1tts/buck-converter-design/Board Sim Pictures/Vdroop 3A-2A.jpg

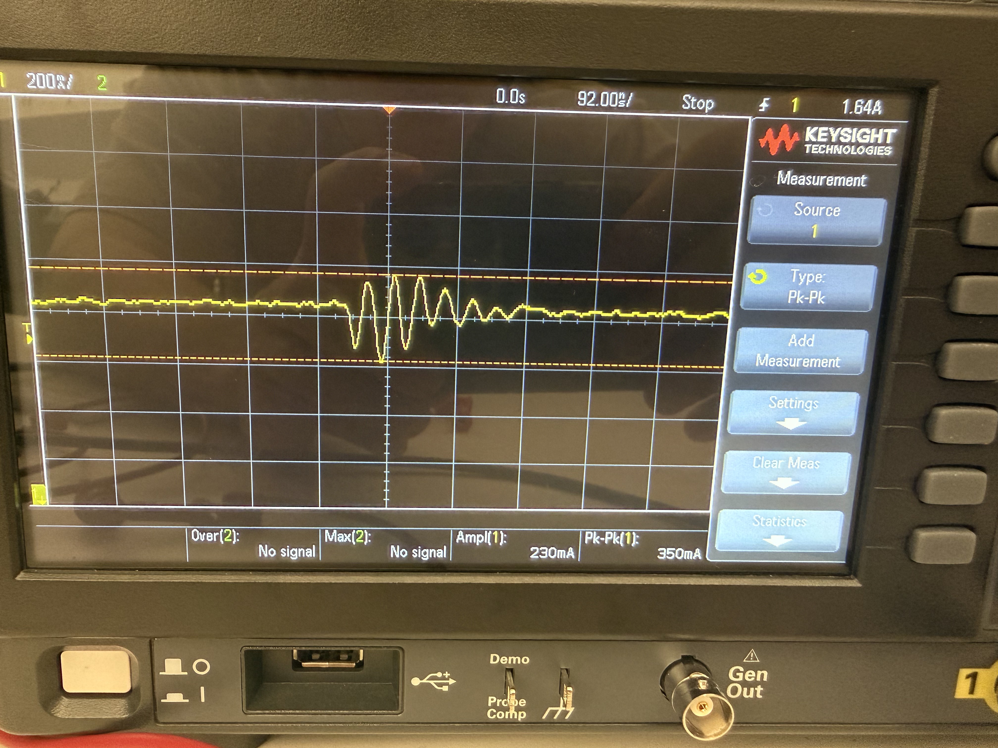
Board Sim Pictures/Vdroop 3A-2A.jpg
