1tts/buck-converter-design/Board Sim Pictures/Output Ripple @ full load.jpg

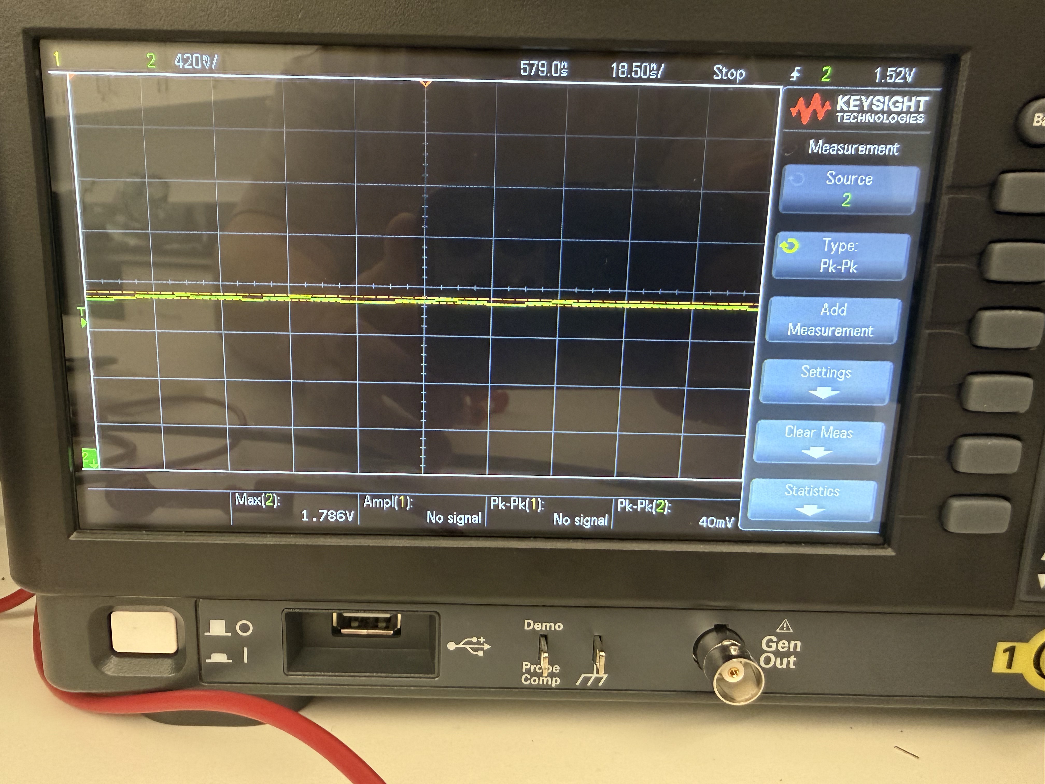
Board Sim Pictures/Output Ripple @ full load.jpg
