1tts/buck-converter-design/README.md

# Design & Schematics for 5V - 1.8V DC Synchronous Buck Converter
