1tts/buck-converter-design/Board Sim Pictures/board.jpg

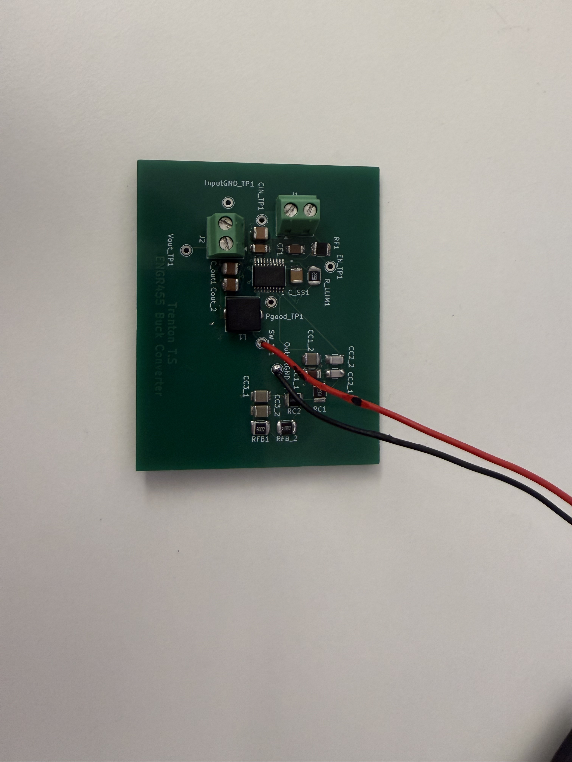
Board Sim Pictures/board.jpg
