1tts/buck-converter-design/Board Sim Pictures/DC Out.jpg

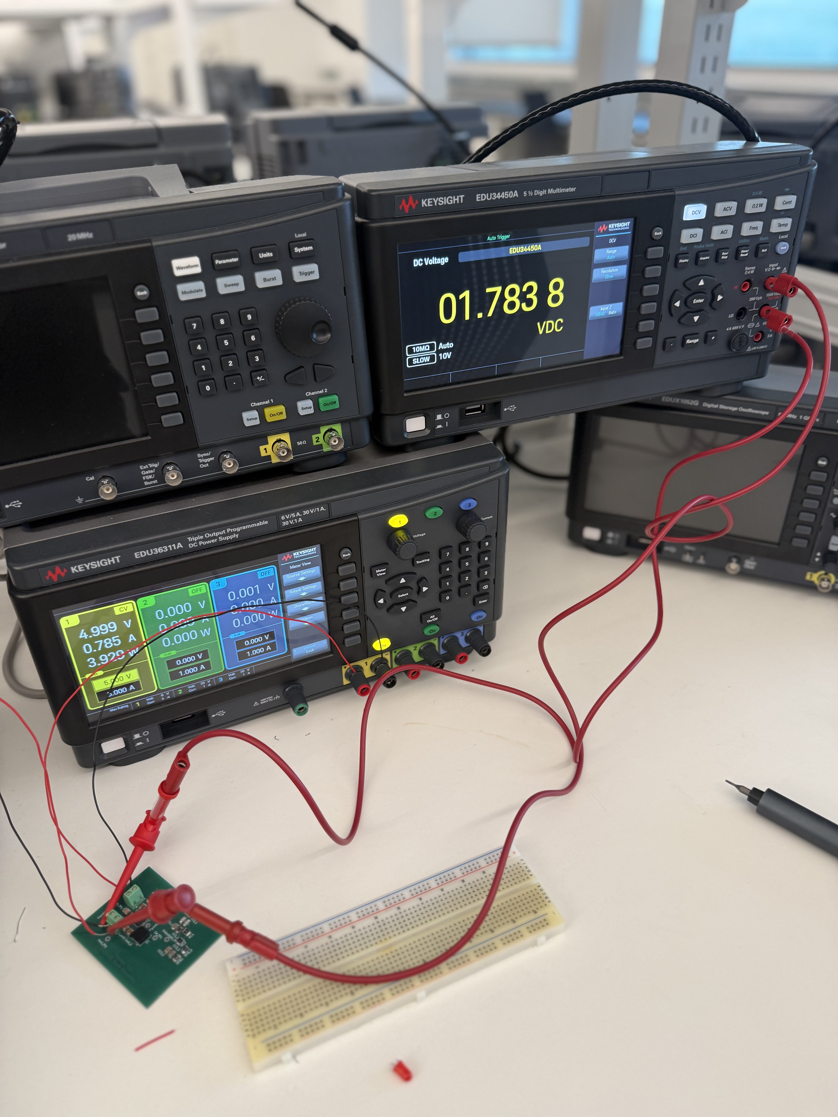
Board Sim Pictures/DC Out.jpg
