1tts/buck-converter-design/Board Sim Pictures/full-load confirmation.png

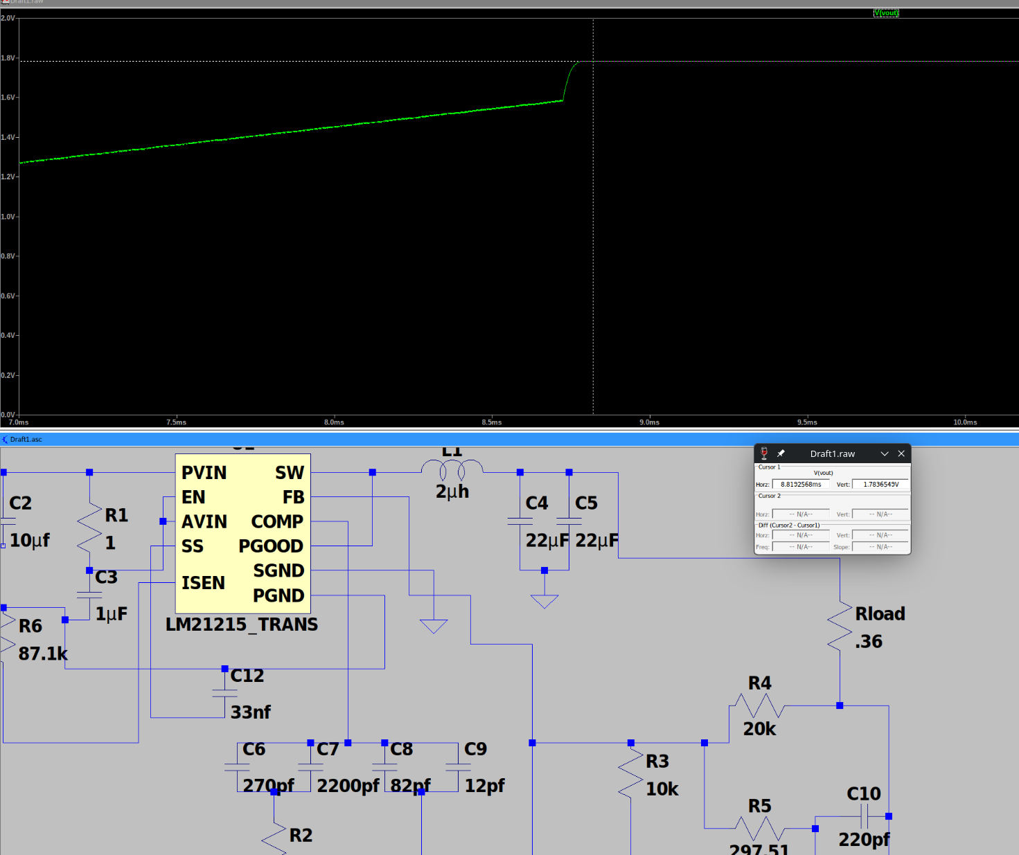
Board Sim Pictures/full-load confirmation.png
