1tts/buck-converter-design/Board Sim Pictures/IMG_9958.jpg

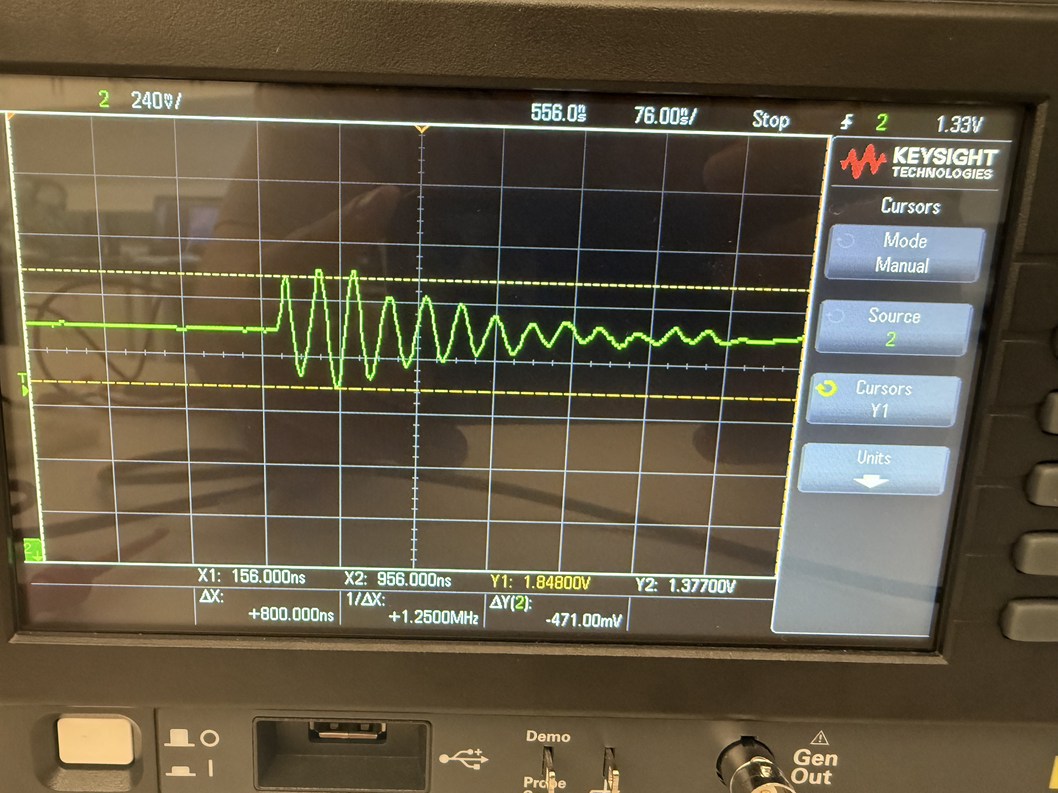
Board Sim Pictures/IMG_9958.jpg
