1tts/buck-converter-design/Board Sim Pictures/inductor_ripple.png

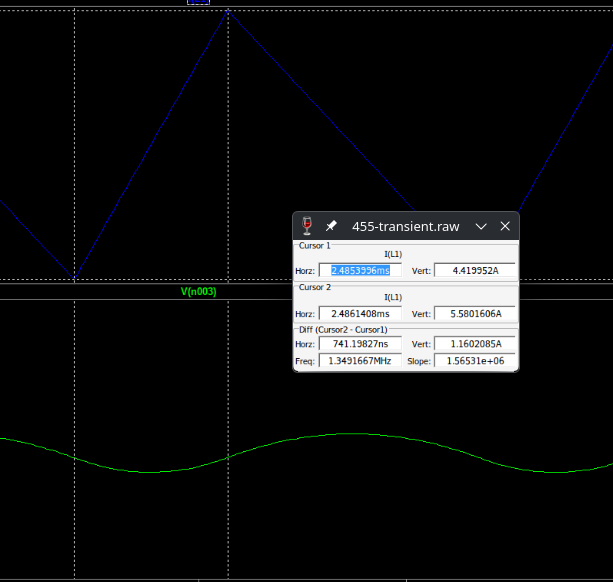
Board Sim Pictures/inductor_ripple.png
