1tts/buck-converter-design/Board Sim Pictures/load_spike_vdroop_pass.png

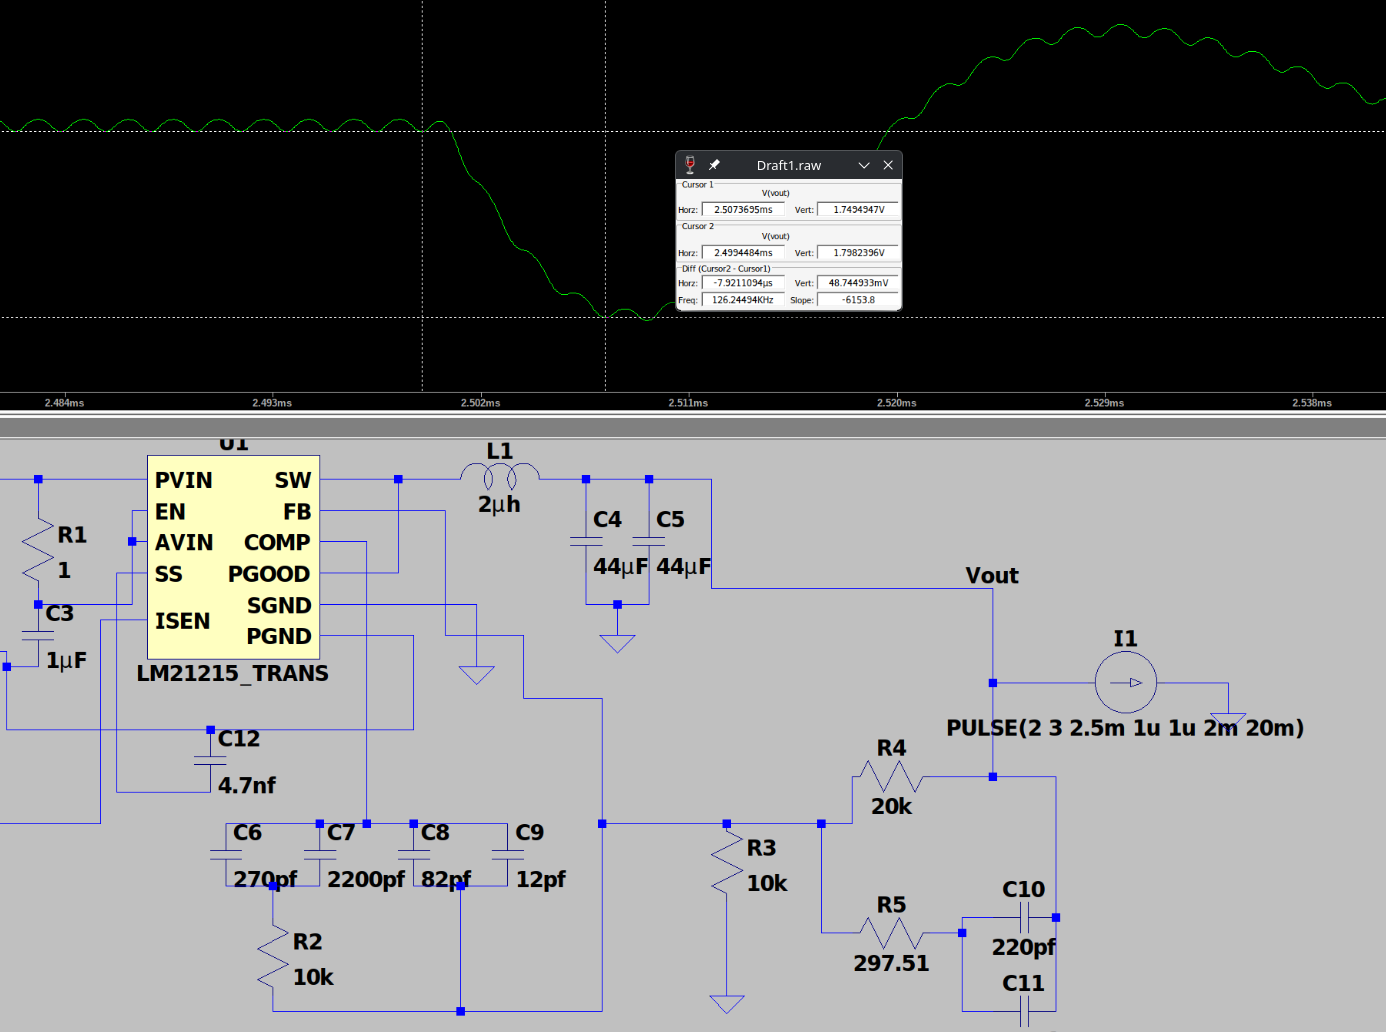
Board Sim Pictures/load_spike_vdroop_pass.png
