1tts/buck-converter-design/Board Sim Pictures/transient-2-rings.png

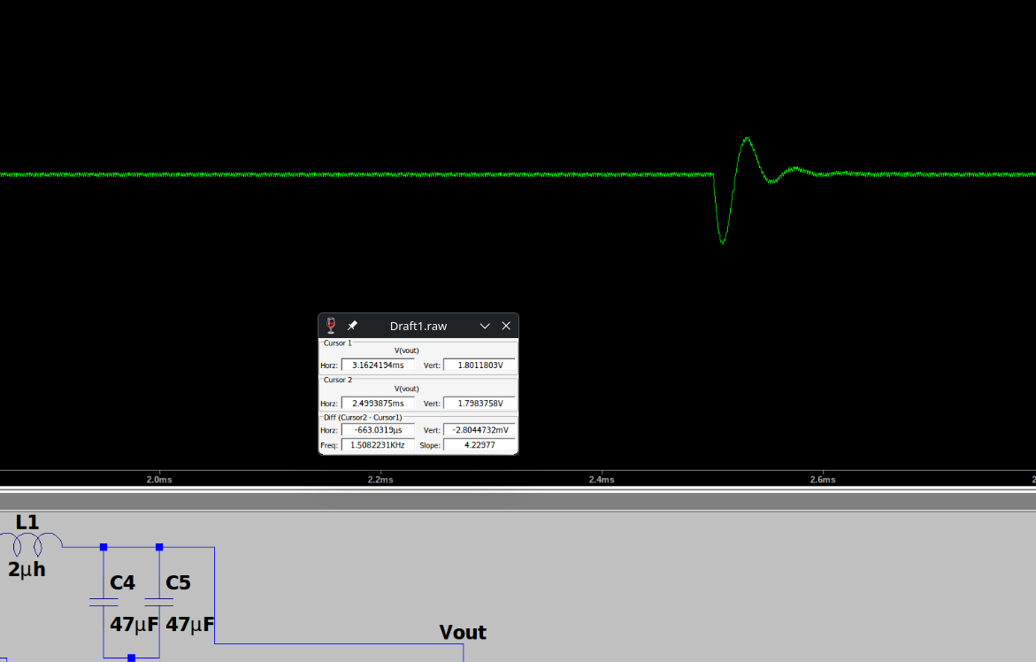
Board Sim Pictures/transient-2-rings.png
