1tts/buck-converter-design/Board Sim Pictures/transient-confirmation.png

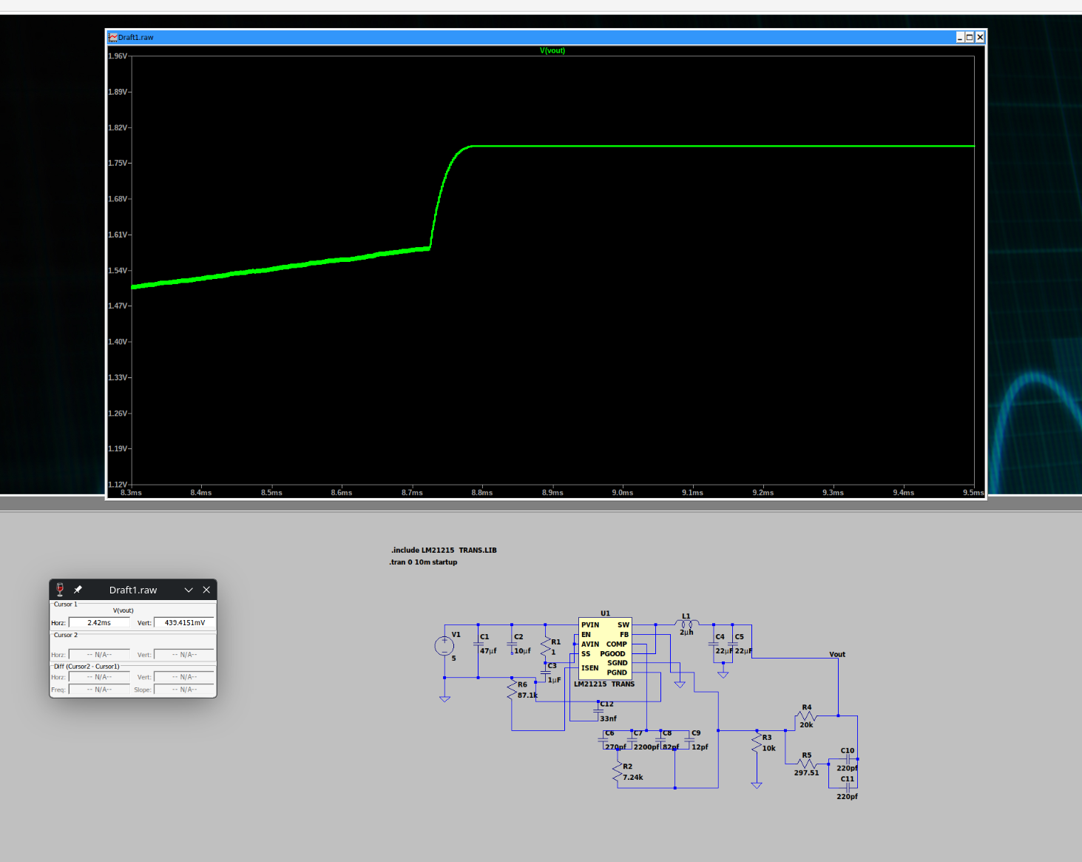
Board Sim Pictures/transient-confirmation.png
