1tts/buck-converter-design/Board Sim Pictures/Vdroop 2A-3A.jpg

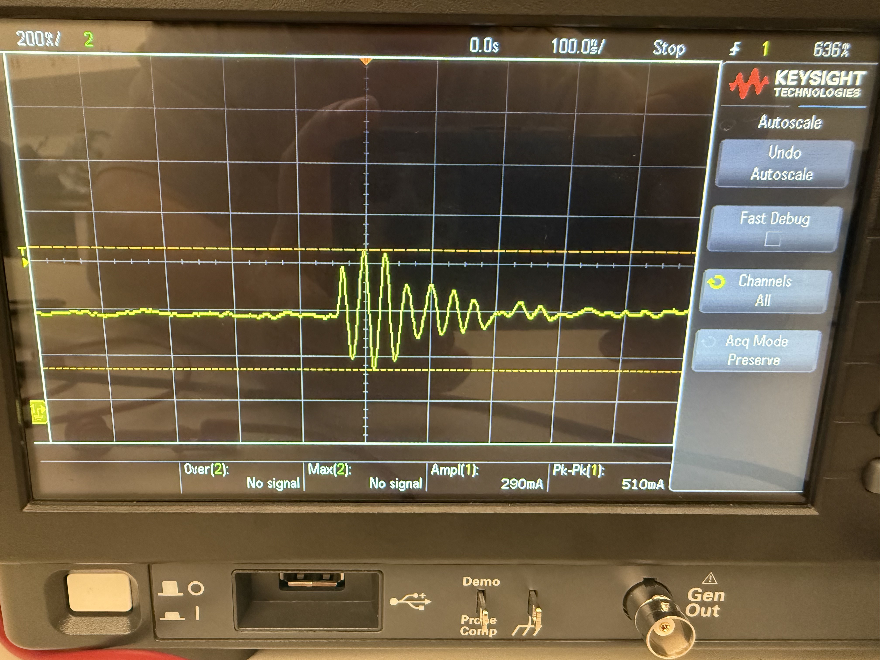
Board Sim Pictures/Vdroop 2A-3A.jpg
