1tts/buck-converter-design/Board Sim Pictures/Vdroop-2Aload.png

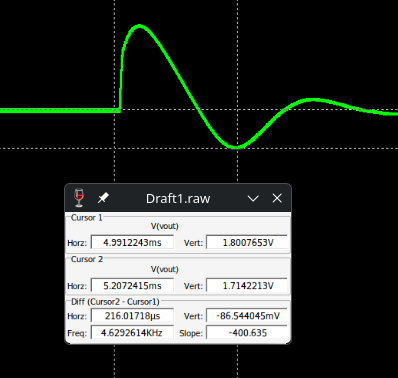
Board Sim Pictures/Vdroop-2Aload.png
