1tts/buck-converter-design/Board Sim Pictures/Vout_ripple.png

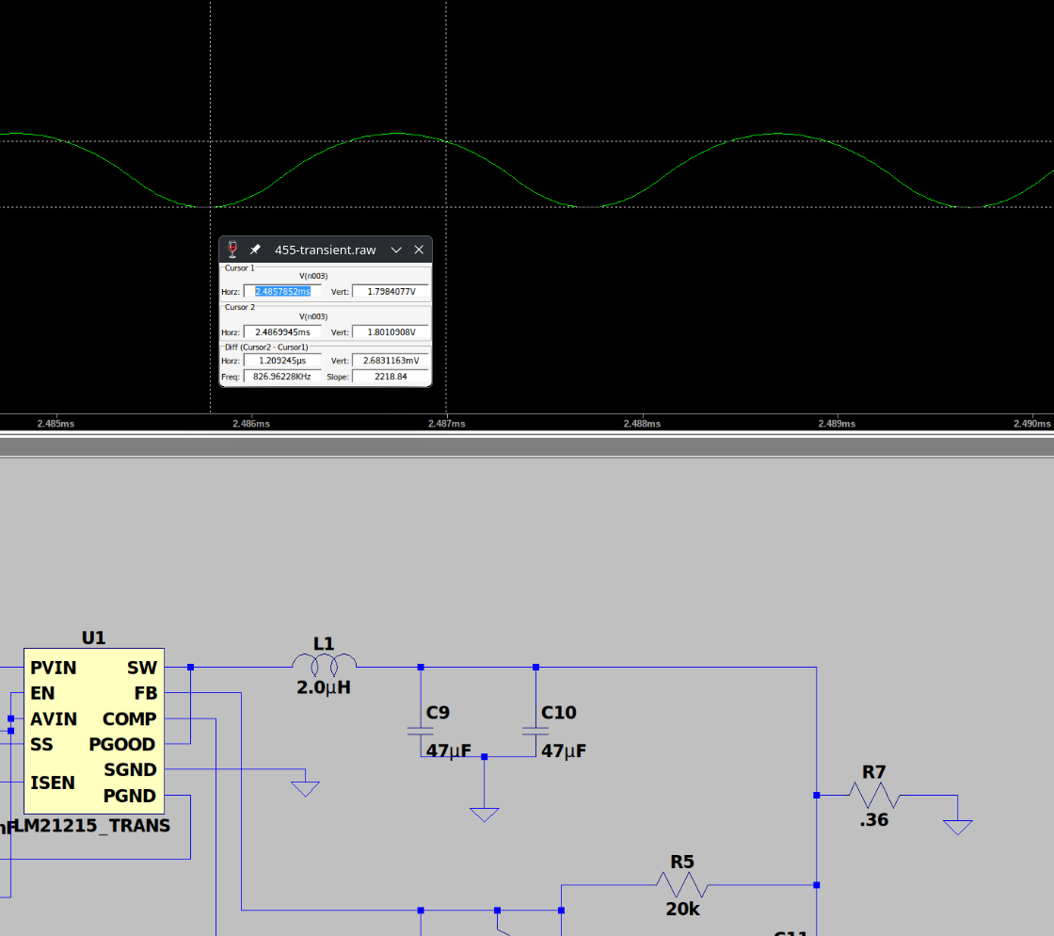
Board Sim Pictures/Vout_ripple.png
