1tts/buck-converter-design/Design/sims/freq analysis/455-freq.asc

CC1_1: cap; 270pF
CC1_2: cap; 2200pF
CC2_1: cap; 82pF
CC2_2: cap; 12pF
CC3_1: cap; 220pF
CC3_2: cap; 220pF
Cin1: cap; 47µF
Cin2: cap; 10µF
Cout1: cap; 47µF
Cout2: cap; 47µF
L1: ind; 2µH; Rser=1m
R_fullload: res; .36
RC1: res; 10k
RC2: res; 297.51k
RFB1: res; 20k
RFB2: res; 10k
U1: LM21215_AVG; L=.65u FSW=500k
V1: voltage; 5V
V2: voltage; AC 1 DC 0
Named nets: 0, out, in
.include LM21215_AVG.LIB
.ac dec 100 1 100Meg
