1tts/buck-converter-design/Design/sims/transient/455-transient.asc

C1: cap; 47µF
C2: cap; 10µF
C3: cap; 4.7nF
C4: cap; 1µF
C5: cap; 270pF
C6: cap; 2200pF
C7: cap; 82pF
C8: cap; 12pF
C9: cap; 47µF
C10: cap; 47µF
C11: cap; 220pF
C12: cap; 220pF
I1: current; PULSE(1 5 2.5m 1u 1u 2m 20m)
L1: ind; 2.0µH; Rser=1m
R1: res; 41.2k
R2: res; 1
R3: res; 10k
R4: res; 10k
R5: res; 20k
R6: res; 297.51
U1: LM21215_TRANS
V1: voltage; 5V
Named nets: 0
.include LM21215_TRANS.LIB
.tran 0 20m startup
