1tts/buck-converter-design/Design/final/final.kicad_pcb

## KiCad design Design/final/final.kicad_pcb (2026-11-03)

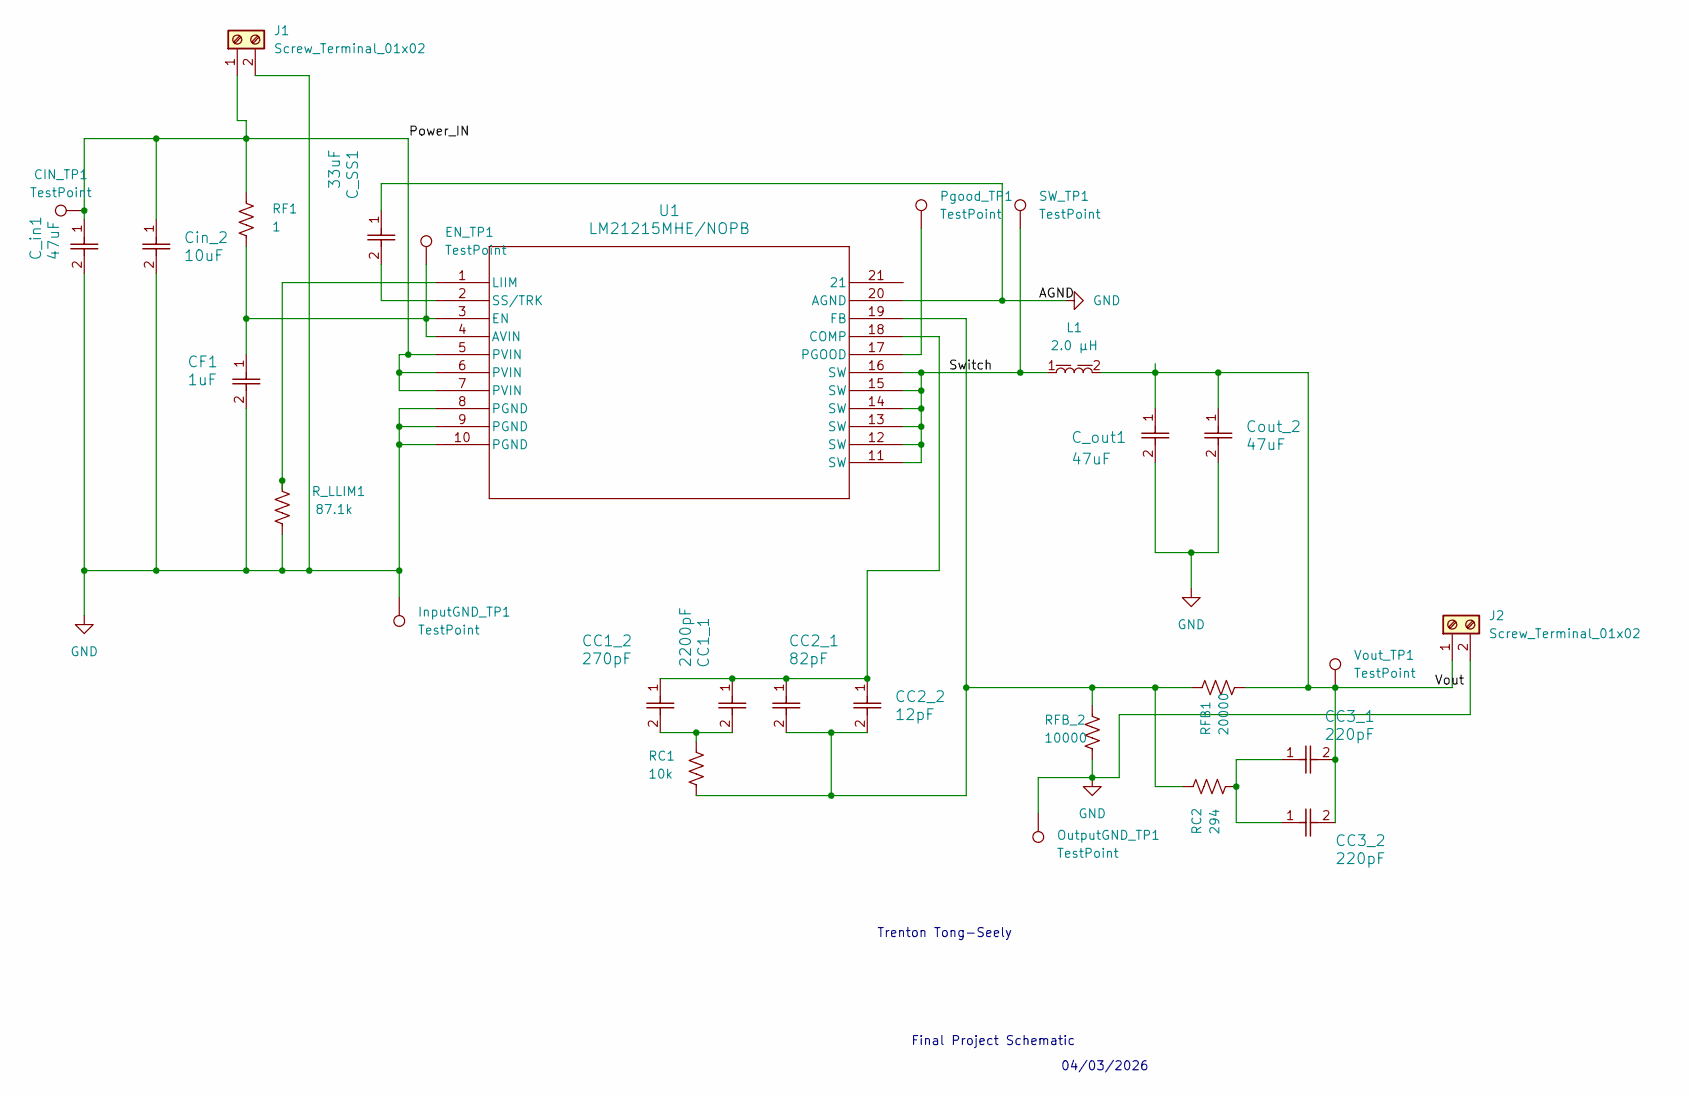
[picture p32: schematic final.kicad_sch]

Parts:
CC1_1: 2200pF; CAP_GRM_3p4x1p8x1_MUR
CC1_2: 270pF; CAP_1206J_AVX
CC2_1: 82pF; CAP_1206J_AVX
CC2_2: 12pF; CAP_1206J_AVX
CC3_1, CC3_2: 220pF; CAP_GRM_3p4x1p8x1_MUR
CF1: 1uF; CAP_1206J_AVX
CIN_TP1: TestPoint; TestPoint_THTPad_D2.0mm_Drill1.0mm
C_SS1: 33uF; CAP_GRM_3p4x1p8x1_MUR
C_in1: 47uF; CAP_GRM_3p4x1p8x1_MUR
C_out1: 47uF; CAP_GRM_3p4x1p8x1_MUR
Cin_2: 10uF; CAP_1206J_AVX
Cout_2: 47uF; CAP_GRM_3p4x1p8x1_MUR
EN_TP1: TestPoint; TestPoint_THTPad_D2.0mm_Drill1.0mm
InputGND_TP1: TestPoint; TestPoint_THTPad_D2.0mm_Drill1.0mm
J1, J2: Screw_Terminal_01x02; TerminalBlock_Phoenix_MKDS-1-2-3.81_1x02_P3.81mm_Horizontal
L1: 7030_7843100200; L_Wurth_WE-HCIA-7030; Part Number 7843100200
OutputGND_TP1: TestPoint; TestPoint_THTPad_D2.0mm_Drill1.0mm
Pgood_TP1: TestPoint; TestPoint_THTPad_D2.0mm_Drill1.0mm
RC1: 10k; R_1210_3225Metric
RC2: 294; R_1210_3225Metric
RF1: 1; R_1210_3225Metric
RFB1: 20000; R_1210_3225Metric
RFB_2: 10000; R_1210_3225Metric
R_LLIM1: 87.1k; R_1210_3225Metric
SW_TP1: TestPoint; TestPoint_THTPad_D2.0mm_Drill1.0mm
U1: LM21215MHE/NOPB; MYB20AA
Vout_TP1: TestPoint; TestPoint_THTPad_D2.0mm_Drill1.0mm

Connections:
/<NO NET>: L1.1, SW_TP1.1 (1_1), U1.11 (SW), U1.12 (SW), U1.13 (SW), U1.14 (SW), U1.15 (SW), U1.16 (SW)
/Power_IN: CIN_TP1.1 (1_1), C_in1.1, Cin_2.1, J1.1, RF1.1, U1.5 (PVIN), U1.6 (PVIN), U1.7 (PVIN)
/Vout: CC3_1.2, CC3_2.2, C_out1.1, Cout_2.1, J2.1, L1.2, RFB1.2, Vout_TP1.1 (1_1)
GND: CF1.2, C_SS1.1, C_in1.2, C_out1.2, Cin_2.2, Cout_2.2, InputGND_TP1.1 (1_1), J1.2, J2.2, OutputGND_TP1.1 (1_1), RFB_2.2, R_LLIM1.2, U1.8 (PGND), U1.9 (PGND), U1.10 (PGND), U1.20 (AGND), U1.EPAD
unnamed: CC1_1.2, CC1_2.2, RC1.1
unnamed: CC3_1.1, CC3_2.1, RC2.2
unnamed: CF1.1, EN_TP1.1 (1_1), RF1.2, U1.3 (EN), U1.4 (AVIN)
unnamed: CC1_1.1, CC1_2.1, CC2_1.1, CC2_2.1, U1.18 (COMP)
unnamed: CC2_1.2, CC2_2.2, RC1.2, RC2.1, RFB1.1, RFB_2.1, U1.19 (FB)
unnamed: R_LLIM1.1, U1.1 (LIIM)
unnamed: Pgood_TP1.1 (1_1), U1.17 (PGOOD)
unnamed: C_SS1.2, U1.2 (SS/TRK)

Notes on the sheet:
Final Project Schematic
Trenton Tong-Seely
04/03/2026

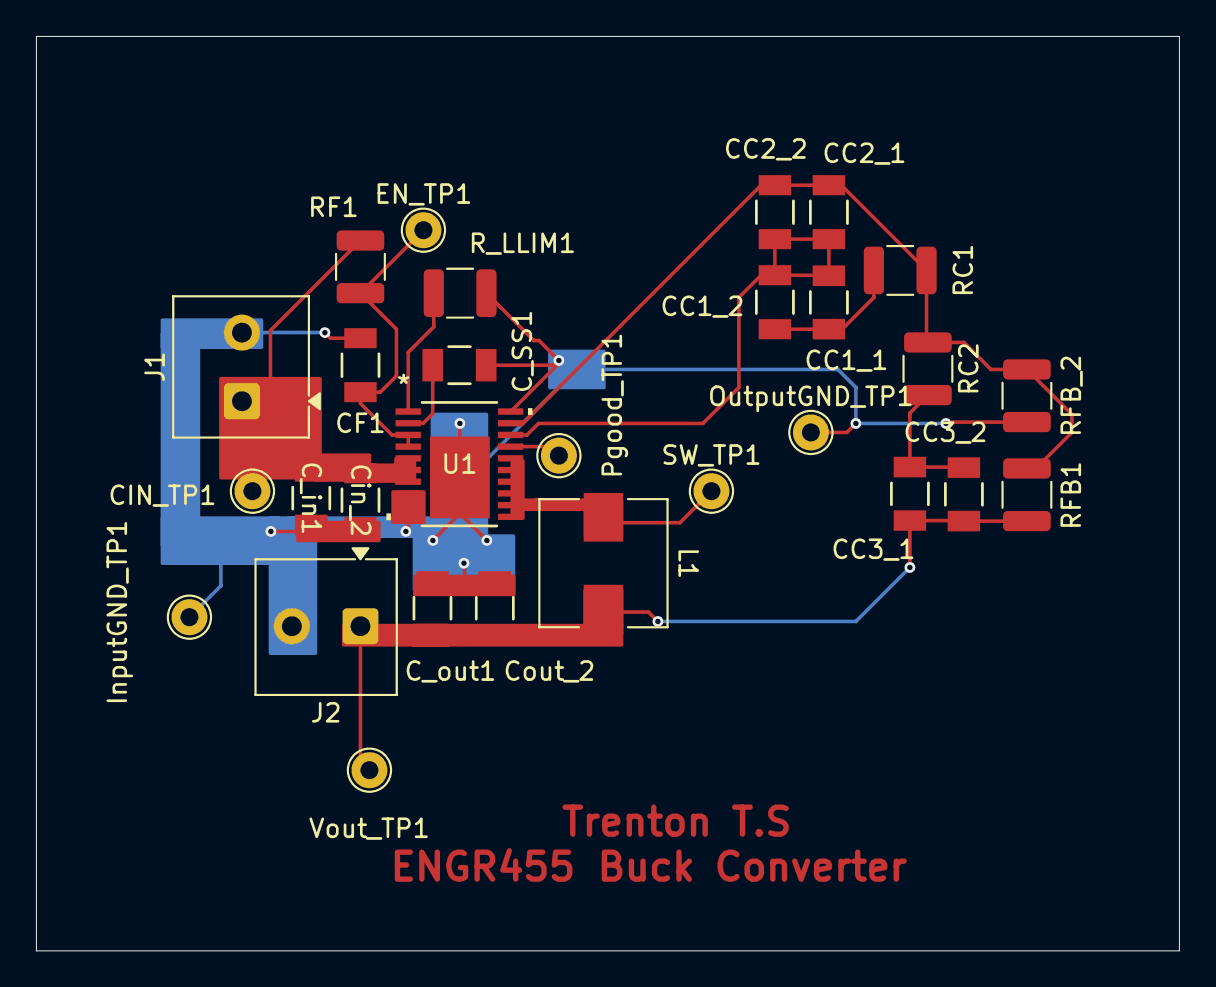
[picture p33: board final.kicad_pcb from above]

Board: 2 copper layers, 63.5 x 50.8 mm, 29 parts (0 on the bottom side), 12 nets.
